hothiennhan021/ascon-aead128-genesys2/(commit log)

2026-09-02 Fix premature plaintext release on tag failure; add decrypt and negative tests
    [ascon_aead_fsm.v, tb_aead.v]
2026-09-02 Rewrite byte-mask logic as case: -258 LUT; investigate CARRY4 chain
2026-09-03 Add 3-point PPA table and Pareto analysis (RPC=1/2/4) to uarch.md
    Documents throughput/LUT tradeoff across ROUNDS_PER_CYCLE=1,2,4: RPC=2
    is the Pareto-optimal point (1.89 Mbps/LUT), RPC=4 reverses the trend
    (1.07, worse than RPC=1) since combinational chain depth outgrows the
    cycle-count win. Also records the RPC=1 critical path re-measurement
    under the rewritten two-stage sweep_fmax.tcl grid (182.25 MHz, limited
    by a CARRY4 tag-compare chain in ascon_aead_fsm, not the round
    datapath) and generalizes section 3.1's cycle-budget formula to any
    ROUNDS_PER_CYCLE=R dividing 12 and 8.
2026-09-03 Add gate-level sim + power + timing evidence for RPC=1 (step 8)
    Gate-level functional simulation (write_verilog -mode funcsim) of
    post_route_rpc1.dcp through 20 selected KAT vectors (5x empty AD, 5x
    empty PT, 5x odd final block, 5x 16-byte-multiple length) passes
    20/20, confirming the placed-and-routed netlist is functionally
    correct. SAIF captured from that same run feeds report_power (100%
    net match, 91 mW total on-chip); report_timing_summary on the same
    checkpoint gives the static timing signoff evidence (WNS=+0.013 ns,
    all constraints met).
    Gate-level *timing* simulation (SDF back-annotation) was attempted
    first but abandoned: this Vivado 2022.2 install's unisims_ver
    simulation library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
    [ppa.csv]
2026-09-03 Add APB corner-case tests: underflow, overwrite, unmapped addr, reset, back-to-back
    [ascon_perm.v, tb_apb.v]
2026-09-03 Multi-device PPA: Artix-7 182 MHz, Kintex-7 304 MHz, Virtex-7 273 MHz
    [ppa_multidevice.csv]
2026-09-03 Add Genesys 2 UART demo: RTL, XDC, system testbench, host script
2026-09-27 Fix bus-level security and robustness bugs in ascon_apb/ascon_aead_fsm
    - Never publish the computed tag on decrypt (TAG0..3 read 0, tag_valid=0);
    it handed out a valid tag for a forged message.
    - Latch mode at INIT: sending the last block/FINAL with mode=0 in a decrypt
    session released the last block early and forced tag_fail=0.
    - Clear tag_fail, tag and the held block on INIT and SOFT_RESET; SOFT_RESET
    also scrubs the permutation state, DOUT/TAG/DIN/TAGIN.
    - din_full now tracks which of the 4 DIN words were written (the 3-bit
    write counter accepted 4 writes to one word and wrapped after 8).
    - Reject reserved opcodes, last=1 with valid_bytes>15, out-of-order
    commands and mode misma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
    [apb_checker.v, ascon_aead_fsm.v, ascon_apb.v, tb_aead.v, tb_apb.v, tb_apb_session.v, tb_gatesim.v, uart_kat.py]
2026-09-27 Add long-message test, KAT hex generator and fail-fast portable Makefile
    - tb_long.v: 60 random vectors with AD/PT up to 255 bytes (16 blocks),
    encrypt + decrypt against the Python model (gen_long_vectors.py).
    - gen_kat_hex.py regenerates kat_128_128.hex from the NIST file
    byte-for-byte; `make hexcheck` verifies it.
    - model --run-kat also checks decryption and rejection of a bad tag.
    - scripts/run_sim.py turns FAIL lines into a non-zero exit code, so
    `make regress` stops on the first failing testbench.
    - Makefile runs from cmd.exe on Windows and sh on Linux/macOS; kat now
    includes tb_apb_session and tb_long; new regress_all target.
    [gen_kat_hex.py, gen_long_vectors.py, run_sim.py, tb_long.v]
2026-09-27 Add CI, test plan and correct README/comparison claims
    - GitHub Actions runs model, hexcheck, regress for RPC=1/2/4 and demo_sim.
    - docs/test_plan.md maps every spec requirement to a testbench.
    - README: bus-level verification, accurate scope of the last-block hold,
    APB-bound throughput, CARRY4 root cause, note that PPA predates v0.2.
    - comparison.md: RPC=1 critical path is the tag compare, not the round
    datapath; throughput/power comparison caveats.
